pinkfish/hotswap_toolhead/gerber/toolhead-bom-jlcpcb.csv

Comment | Designator | Footprint | LCSC Part #
0R | R7,R8 | R_0402_1005Metric | C17168
100R | R6 | R_0402_1005Metric | C25076
100nF | C6,C9,C12,C15,C16,C19,C20 | C_0402_1005Metric | C1525
100nF | C5 | C_0603_1608Metric | C14663
10k | R1,R3,R13,R14,R16,R22 | R_0402_1005Metric | C25744
10uF 25V X5R | C10,C17 | C_0805_2012Metric | C15850
10uF 50V X5R | C2,C3,C4 | C_1206_3216Metric | C13585
120R | R11 | R_0805_2012Metric | C17437
1k | R4,R5,R15,R19,R23 | R_0402_1005Metric | C11702
1uF | C11 | C_0402_1005Metric | C52923
22uF 25V X5R | C8 | C_1206_3216Metric | C12891
22uH 1.2A (FNR4030S220MT) | L1 | L_Taiyo-Yuden_NR-40xx | C167883
33k | R2 | R_0402_1005Metric | C25779
33pF C0G | C13,C14 | C_0402_1005Metric | C1562
4.12k 0.1% 25ppm | R18 | R_0402_1005Metric | C852812
4.7k 0.1% 25ppm | R17 | R_0402_1005Metric | C281778
47uF 50V 105C | C1 | CP_Elec_6.3x7.7 | C72523
5.1k | R20,R21 | R_0402_1005Metric | C25905
600R@100MHz | FB1 | L_0402_1005Metric | C76884
6A 1206 fuse (BSMD1206C-1600T) | F1 | Fuse_1206_3216Metric | C49328461
8MHz 20pF 3225 | Y1 | Crystal_SMD_3225-4Pin_3.2x2.5mm | C9002
BAT54S | D6 | SOT-23 | C7420333
BOOT | SW2 | SW_SPST_EVQP7C | C528965
DSK110 100V 1A | D3,D5,D7,D9 | D_SOD-123F | C22466354
Fan/therm/sensor (Nano-Fit 2x3) | J3 | Molex_Nano-Fit_105314-xx06_2x03_P2.50mm_Horizontal | C586245
Heater (Nano-Fit 2) | J2 | Molex_Nano-Fit_105313-xx02_1x02_P2.50mm_Horizontal | C564339
LMR16006XDDC | U1 | SOT-23-6 | C87080
MMSZ5242B 12V | D2 | D_SOD-123 | C19077426
N-FET 60V <=30mR@2.5V | Q2 | Vishay_PowerPAK_1212-8_Single
NTC/PT1000 | JP2 | PinHeader_1x02_P2.00mm_Vertical | C541856
NUP2105L | D4 | SOT-23 | C14486
PTC 0.75A 33V (JK-mSMD075-33) | F2 | Fuse_1812_4532Metric | C369169
RESET | SW1 | SW_SPST_EVQP7C | C528965
SMAJ33CA | D1 | D_SMA | C19077549
SQJ461EP-T1_GE3 | Q1 | PowerPAK_SO-8_Single | C3279500
STM32G0B1CBU6 | U6 | QFN-48-1EP_7x7mm_P0.5mm_EP5.6x5.6mm | C5270156
TCAN3414DR | U3 | SOIC-8_3.9x4.9mm_P1.27mm | C22396693
TERM | JP1 | SolderJumper-2_P1.3mm_Open_RoundedPad1.0x1.5mm
USB-C (HRO TYPE-C-31-M-12) | J5 | USB_C_Receptacle_HRO_TYPE-C-31-M-12 | C165948
USBLC6-2SC6 | U5 | SOT-23-6 | C7519
WST6066A | Q3 | SOT-23 | C148352
XT30PW(2+2)-M.G.B | J1 | XT30PW-2+2-M | C19268030
blue | LED2 | LED_0603_1608Metric | C2288
yellow-green | LED1 | LED_0603_1608Metric | C2289
