pinkfish/hotswap_toolhead/hardware/production/bom.csv

Designator | Footprint | Quantity | Value | LCSC Part #
C1 | CP_Elec_6.3x7.7 | 1 | 47uF 50V 105C
C10, C17 | 0805 | 2 | 10uF 25V X5R | C15850
C11 | 0603 | 1 | 1uF | C15849
C12, C15, C16, C19, C5, C6, C9 | 0603 | 7 | 100nF | C14663
C13, C14 | 0603 | 2 | 33pF C0G | C1663
C18 | 0603 | 1 | 100nF 50V | C14663
C2, C3, C4 | 1206 | 3 | 10uF 50V X5R | C13585
C8 | 1206 | 1 | 22uF 25V X5R | C12891
D1 | D_SMB | 1 | SMBJ33CA
D2 | D_SOD-123 | 1 | 12V zener
D3, D5, D7, D9 | D_SMA | 4 | SS210 | C14996
D4 | SOT-23 | 1 | NUP2105L
D6 | SOT-23 | 1 | BAT54S
F1 | 1206 | 1 | 6.3A fast
F2 | 1812 | 1 | PTC 0.75A hold 30V
FB1 | 0603 | 1 | 600R@100MHz | C1002
J1 | XT30PW-2+2-M | 1 | XT30PW(2+2)-M.G.B | C19268030
J2 | Molex_Nano-Fit_105313-xx02_1x02_P2.50mm_Horizontal | 1 | Heater (Nano-Fit 2)
J3 | JST_SH_SM02B-SRSS-TB_1x02-1MP_P1.00mm_Horizontal | 1 | Fan (JST-SH 2 side)
J4 | JST_SH_BM02B-SRSS-TB_1x02-1MP_P1.00mm_Vertical | 1 | Thermistor (JST-SH 2 top)
J5 | JST_SH_SM04B-SRSS-TB_1x04-1MP_P1.00mm_Horizontal | 1 | USB (JST-SH 4)
J6 | Tag-Connect_TC2030-IDC-NL_2x03_P1.27mm_Vertical | 1 | TC2030 SWD
JP1 | SolderJumper-2_P1.3mm_Open_RoundedPad1.0x1.5mm | 1 | TERM
JP2 | PinHeader_1x02_P2.54mm_Vertical | 1 | NTC/PT1000
L1 | L_Taiyo-Yuden_NR-40xx | 1 | 22uH (per datasheet)
LED1 | 0603 | 1 | green
LED2 | 0603 | 1 | blue
Q1 | PowerPAK_SO-8_Single | 1 | P-FET 60V >=8A
Q2, Q3 | Vishay_PowerPAK_1212-8_Single | 2 | N-FET 60V <=30mR@2.5V
R1, R13, R14, R16, R3 | 0603 | 5 | 10k
R10, R12, R7, R8, R9 | 0603 | 5 | 0R | C21189
R11 | 0805 | 1 | 120R | C17437
R15, R19, R4, R5, R6 | 0603 | 5 | 1k
R17 | 0603 | 1 | 4.7k 0.1% 25ppm
R18 | 0603 | 1 | 4.12k 0.1% 25ppm
R2 | 0603 | 1 | FB top (datasheet)
SW1 | SW_SPST_TL3342 | 1 | RESET
SW2 | SW_SPST_TL3342 | 1 | BOOT
U1 | SOT-23-6 | 1 | LMR16006XDDC
U3 | SOIC-8_3.9x4.9mm_P1.27mm | 1 | MAX33012E (check pin 5)
U5 | SOT-23-6 | 1 | USBLC6-2SC6
U6 | LQFP-48_7x7mm_P0.5mm | 1 | STM32G0B1CBT7
Y1 | Crystal_SMD_5032-2Pin_5.0x3.2mm | 1 | 8MHz 20pF | C115962
