pinkfish/hotswap_toolhead/hardware/toolhead.kicad_pcb

## KiCad design hardware/toolhead.kicad_pcb (2026-10-26)

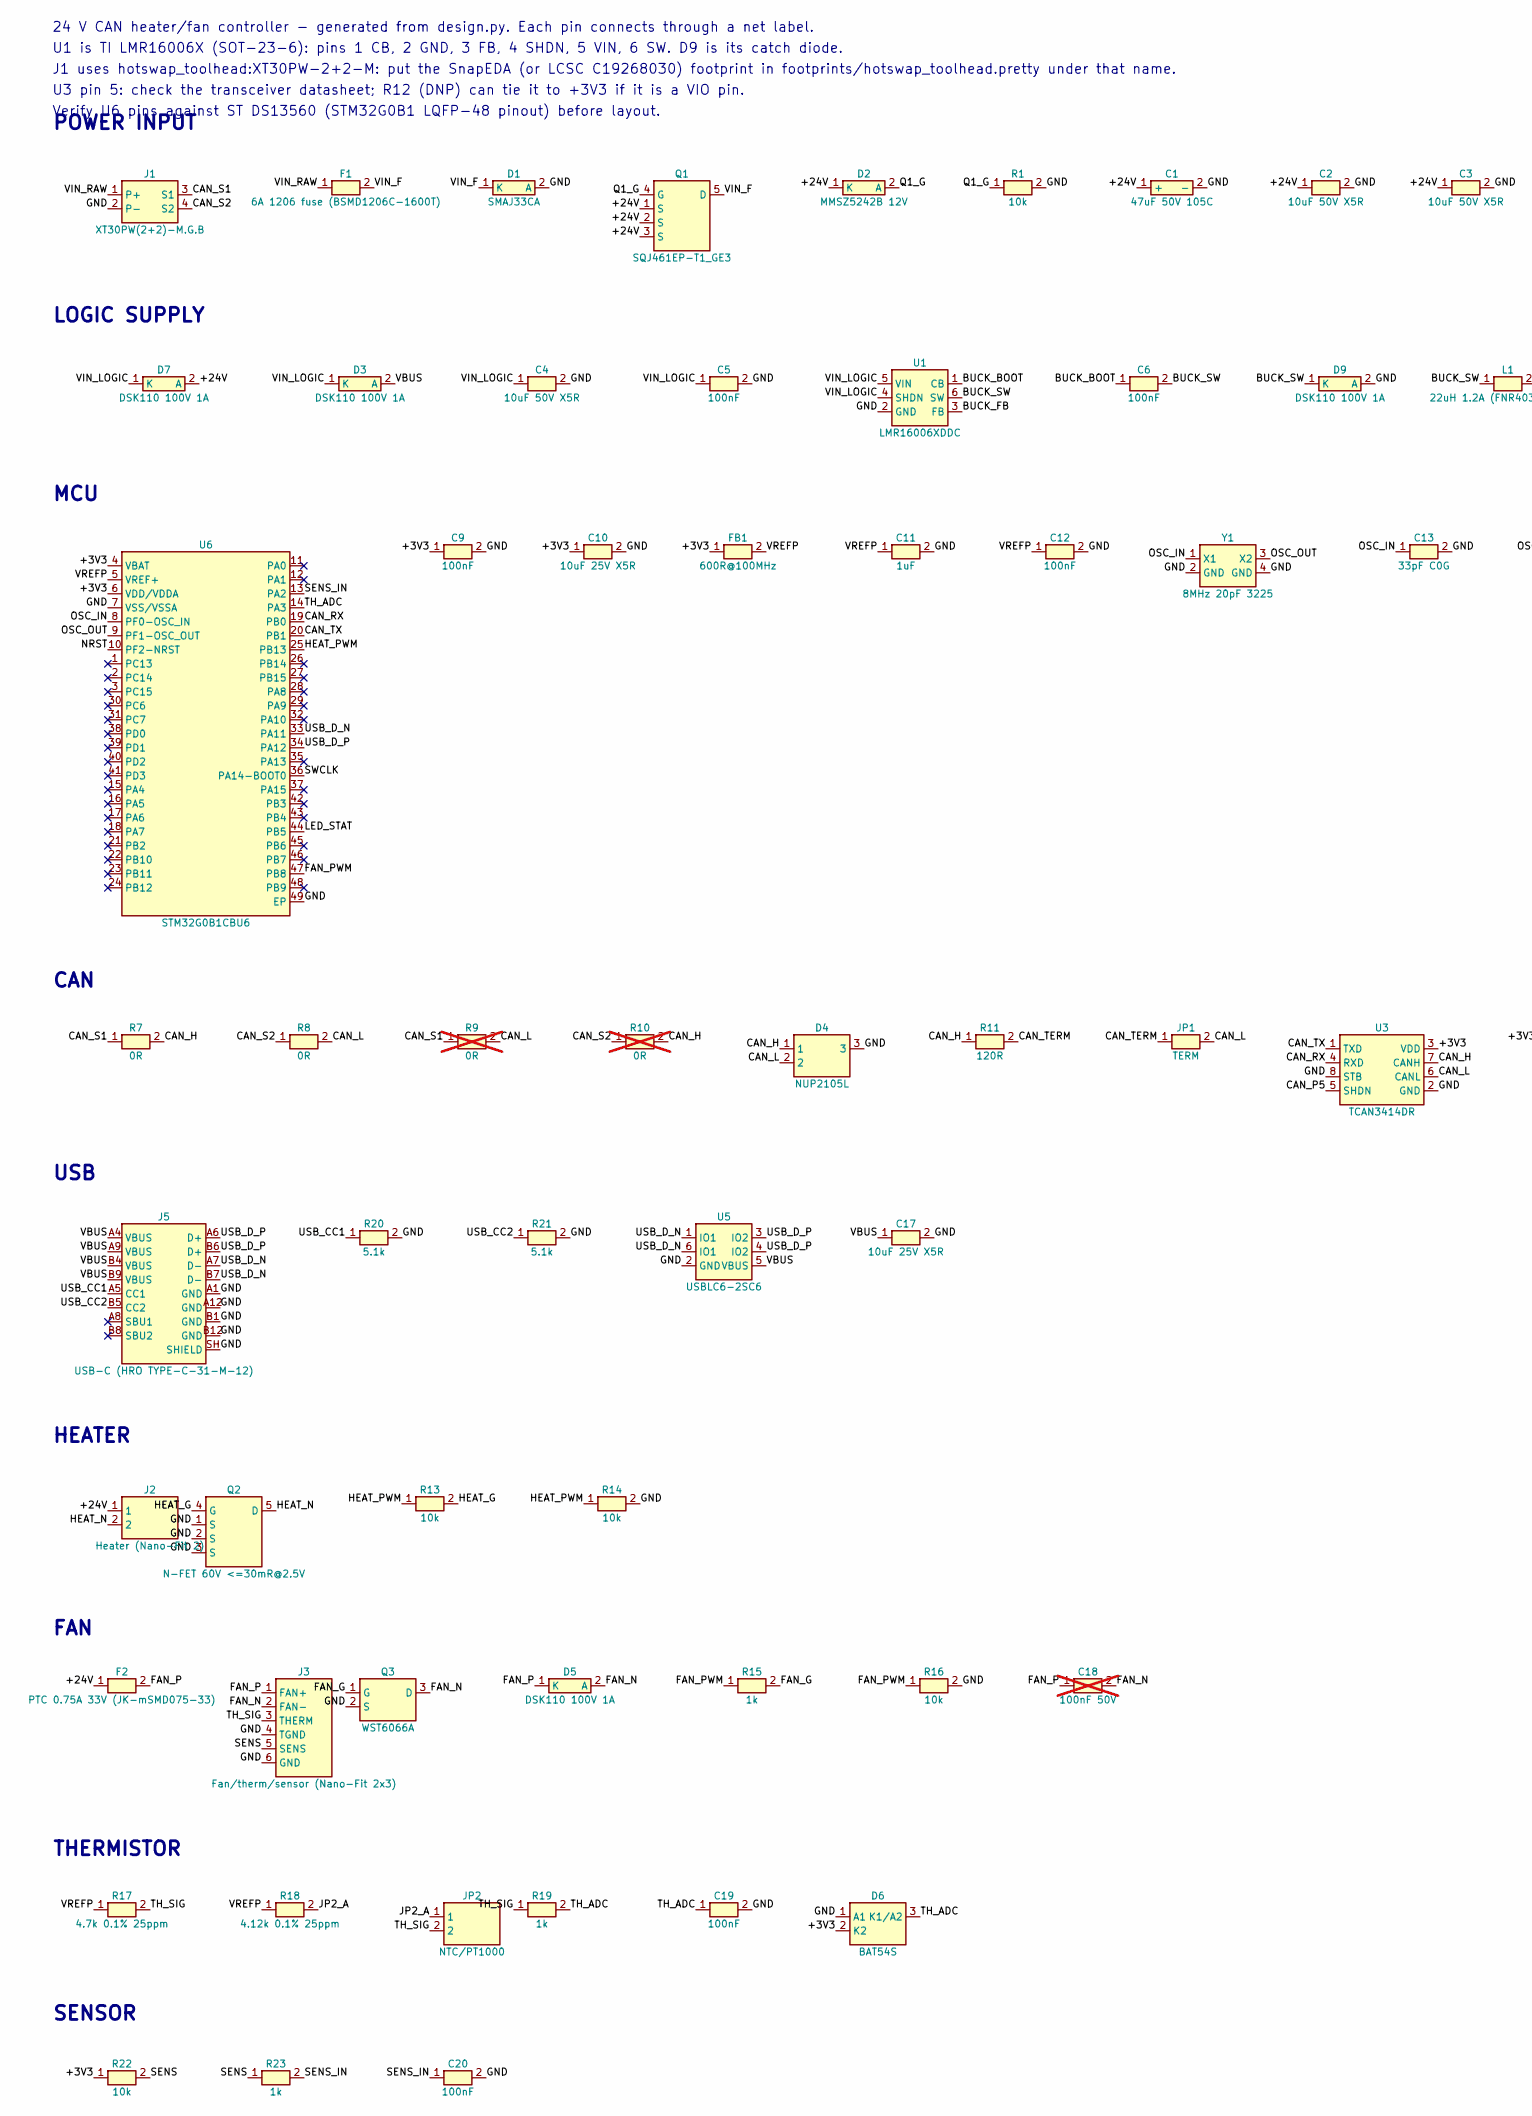
[picture p2: schematic toolhead.kicad_sch, 24V CAN heater/fan controller, part in row 1, column 1]

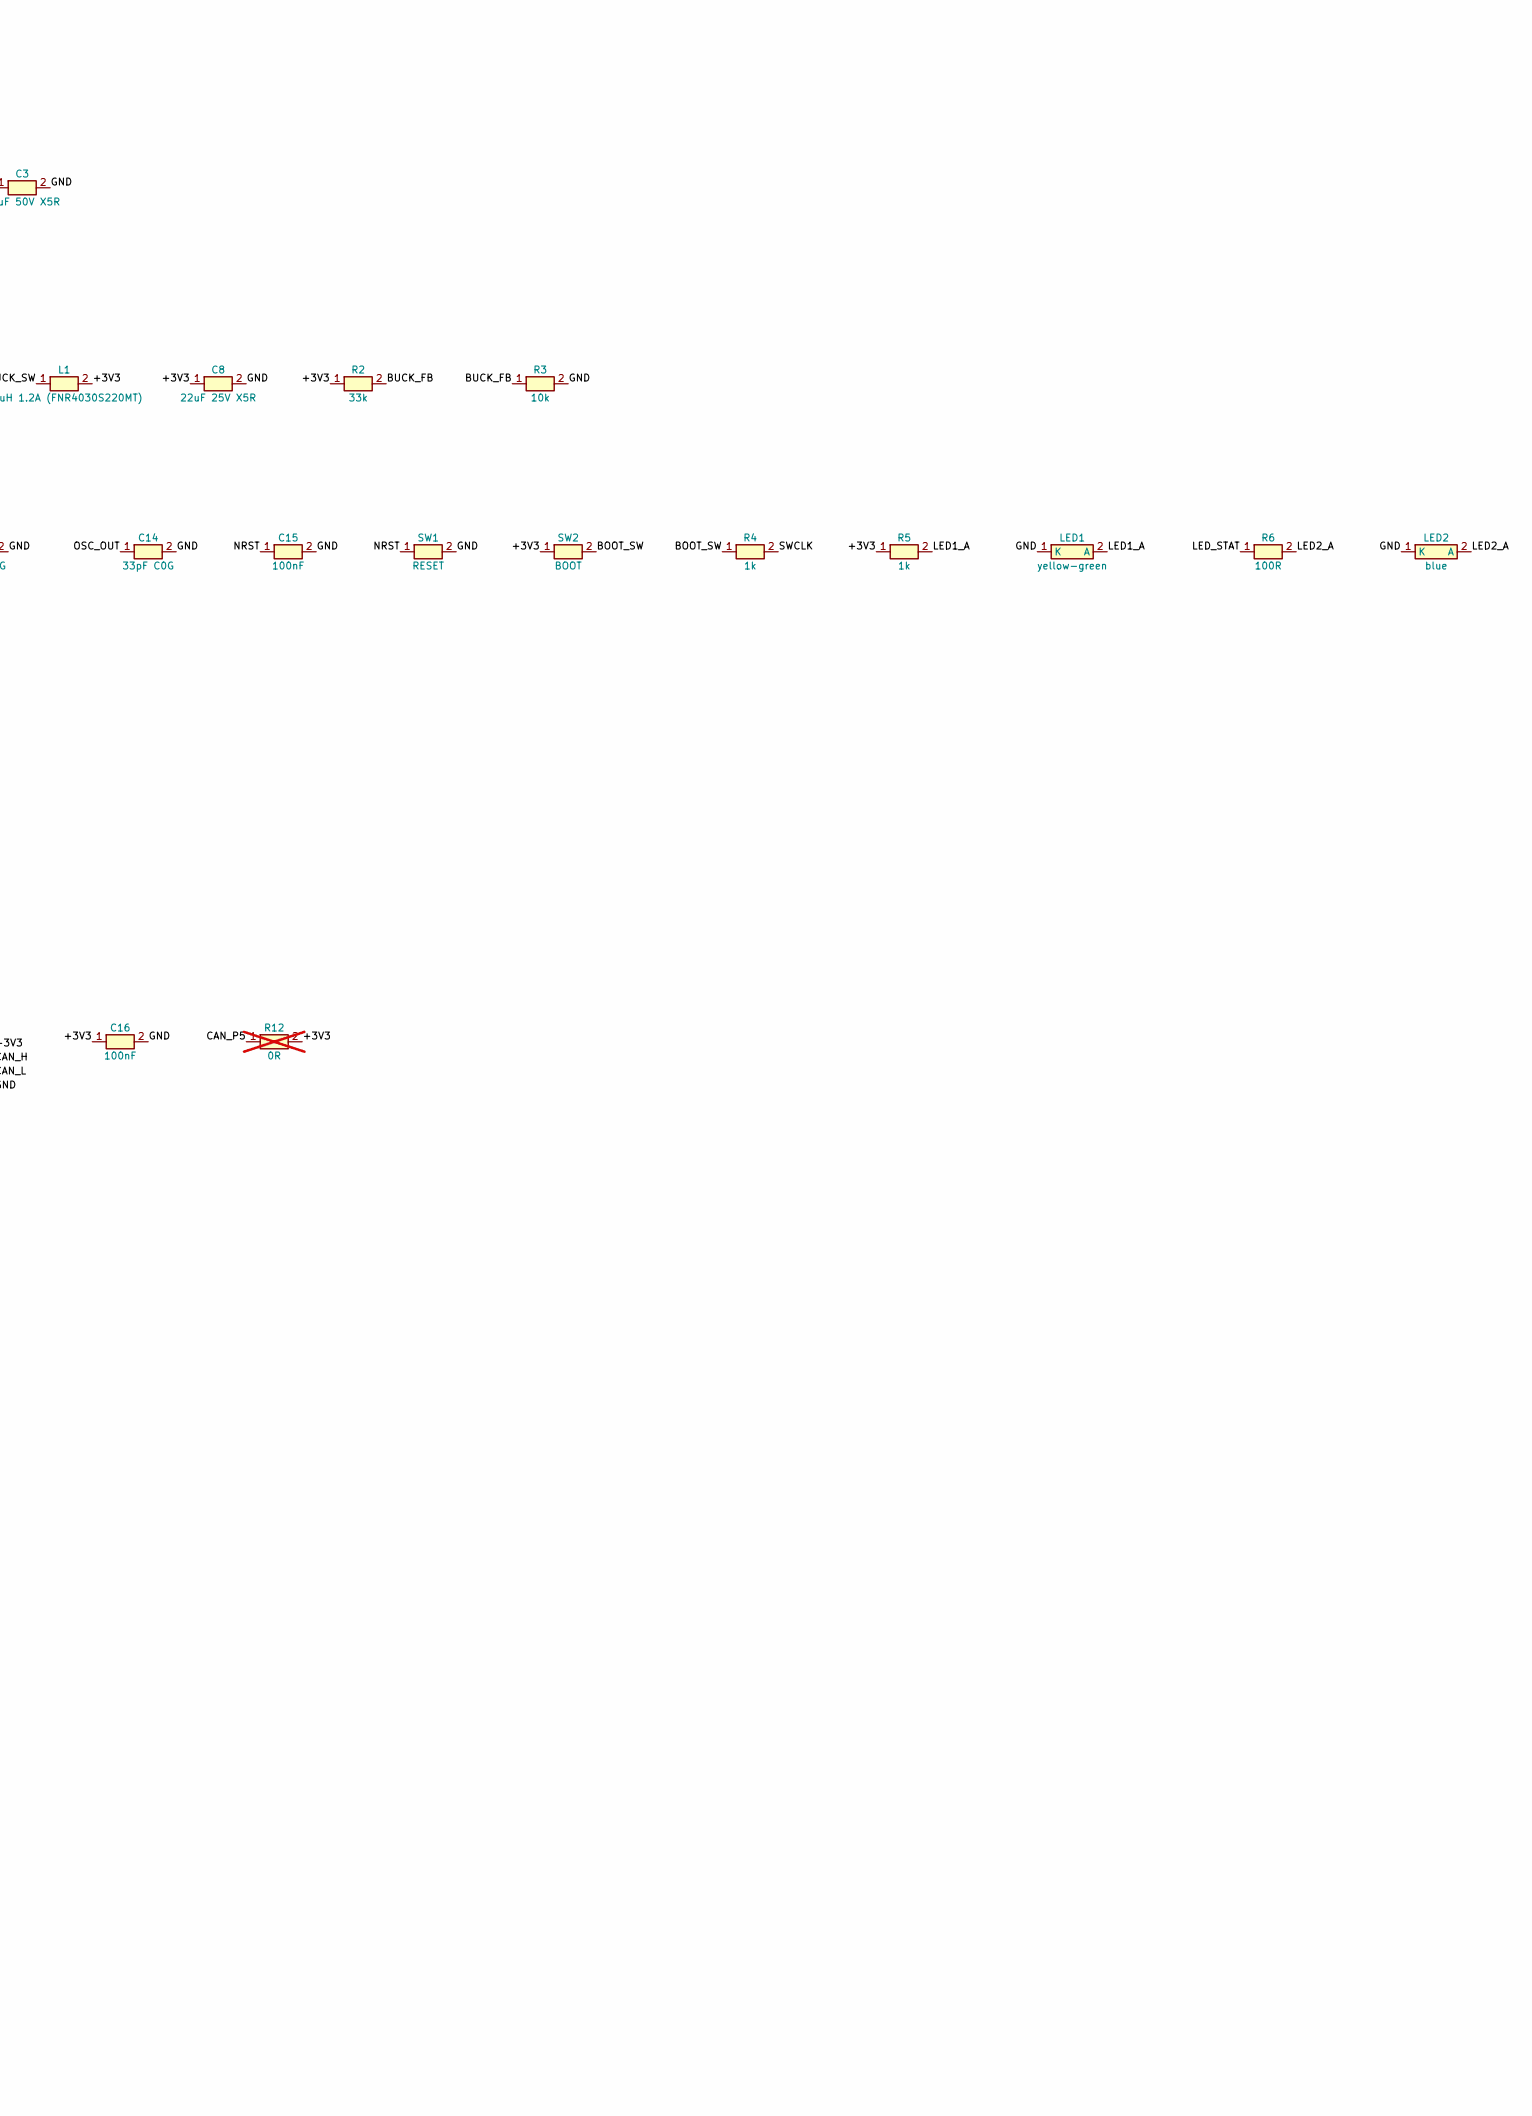
[picture p3: schematic toolhead.kicad_sch, 24V CAN heater/fan controller, part in row 1, column 2]

Parts:
C1: 47uF 50V 105C; CP_Elec_6.3x7.7; LCSC C72523
C2, C3, C4: 10uF 50V X5R; C_1206_3216Metric; LCSC C13585
C5: 100nF; C_0603_1608Metric; LCSC C14663
C6, C9, C12, C15, C16, C19, C20: 100nF; C_0402_1005Metric; LCSC C1525
C8: 22uF 25V X5R; C_1206_3216Metric; LCSC C12891
C10, C17: 10uF 25V X5R; C_0805_2012Metric; LCSC C15850
C11: 1uF; C_0402_1005Metric; LCSC C52923
C13, C14: 33pF C0G; C_0402_1005Metric; LCSC C1562
C18: 100nF 50V; C_0603_1608Metric; LCSC C14663; not fitted
D1: SMAJ33CA; D_SMA; LCSC C19077549
D2: MMSZ5242B 12V; D_SOD-123; LCSC C19077426
D3, D5, D7, D9: DSK110 100V 1A; D_SOD-123F; LCSC C22466354
D4: NUP2105L; SOT-23; LCSC C14486
D6: BAT54S; SOT-23; LCSC C7420333
F1: 6A 1206 fuse (BSMD1206C-1600T); Fuse_1206_3216Metric; LCSC C49328461
F2: PTC 0.75A 33V (JK-mSMD075-33); Fuse_1812_4532Metric; LCSC C369169
FB1: 600R@100MHz; L_0402_1005Metric; LCSC C76884
J1: XT30PW(2+2)-M.G.B; XT30PW-2+2-M; LCSC C19268030
J2: Heater (Nano-Fit 2); Molex_Nano-Fit_105313-xx02_1x02_P2.50mm_Horizontal; LCSC C564339
J3: Fan/therm/sensor (Nano-Fit 2x3); Molex_Nano-Fit_105314-xx06_2x03_P2.50mm_Horizontal; LCSC C586245
J5: USB-C (HRO TYPE-C-31-M-12); USB_C_Receptacle_HRO_TYPE-C-31-M-12; LCSC C165948
JP1: TERM; SolderJumper-2_P1.3mm_Open_RoundedPad1.0x1.5mm
JP2: NTC/PT1000; PinHeader_1x02_P2.00mm_Vertical; LCSC C541856
L1: 22uH 1.2A (FNR4030S220MT); L_Taiyo-Yuden_NR-40xx; LCSC C167883
LED1: yellow-green; LED_0603_1608Metric; LCSC C2289
LED2: blue; LED_0603_1608Metric; LCSC C2288
Q1: SQJ461EP-T1_GE3; PowerPAK_SO-8_Single; LCSC C3279500
Q2: N-FET 60V <=30mR@2.5V; Vishay_PowerPAK_1212-8_Single
Q3: WST6066A; SOT-23; LCSC C148352
R1, R3, R13, R14, R16, R22: 10k; R_0402_1005Metric; LCSC C25744
R2: 33k; R_0402_1005Metric; LCSC C25779
R4, R5, R15, R19, R23: 1k; R_0402_1005Metric; LCSC C11702
R6: 100R; R_0402_1005Metric; LCSC C25076
R7, R8: 0R; R_0402_1005Metric; LCSC C17168
R9, R10, R12: 0R; R_0402_1005Metric; LCSC C17168; not fitted
R11: 120R; R_0805_2012Metric; LCSC C17437
R17: 4.7k 0.1% 25ppm; R_0402_1005Metric; LCSC C281778
R18: 4.12k 0.1% 25ppm; R_0402_1005Metric; LCSC C852812
R20, R21: 5.1k; R_0402_1005Metric; LCSC C25905
SW1: RESET; SW_SPST_EVQP7C; LCSC C528965
SW2: BOOT; SW_SPST_EVQP7C; LCSC C528965
U1: LMR16006XDDC; SOT-23-6; LCSC C87080
U3: TCAN3414DR; SOIC-8_3.9x4.9mm_P1.27mm; LCSC C22396693
U5: USBLC6-2SC6; SOT-23-6; LCSC C7519
U6: STM32G0B1CBU6; QFN-48-1EP_7x7mm_P0.5mm_EP5.6x5.6mm; LCSC C5270156
Y1: 8MHz 20pF 3225; Crystal_SMD_3225-4Pin_3.2x2.5mm; LCSC C9002

Connections:
/+3V3: C8.1, C9.1, C10.1, C16.1, D6.2 (K2), FB1.1, L1.2, R2.1, R5.1, R12.2, R22.1, SW2.1, U3.3 (VDD), U6.4 (VBAT), U6.6 (VDD/VDDA)
/+24V: C1.1 (+), C2.1, C3.1, D2.1 (K), D7.2 (A), F2.1, J2.1, Q1.1 (S), Q1.2 (S), Q1.3 (S)
/BOOT_SW: R4.1, SW2.2
/BUCK_BOOT: C6.1, U1.1 (CB)
/BUCK_FB: R2.2, R3.1, U1.3 (FB)
/BUCK_SW: C6.2, D9.1 (K), L1.1, U1.6 (SW)
/CAN_H: D4.1, R7.2, R10.2, R11.1, U3.7 (CANH)
/CAN_L: D4.2, JP1.2, R8.2, R9.2, U3.6 (CANL)
/CAN_P5: R12.1, U3.5 (PIN5_CHECK)
/CAN_RX: U3.4 (RXD), U6.19 (PB0)
/CAN_S1: J1.3 (S1), R7.1, R9.1
/CAN_S2: J1.4 (S2), R8.1, R10.1
/CAN_TERM: JP1.1, R11.2
/CAN_TX: U3.1 (TXD), U6.20 (PB1)
/FAN_G: Q3.1 (G), R15.2
/FAN_N: C18.2, D5.2 (A), J3.2 (FAN-), Q3.3 (D)
/FAN_P: C18.1, D5.1 (K), F2.2, J3.1 (FAN+)
/FAN_PWM: R15.1, R16.1, U6.47 (PB8)
/GND: C1.2 (-), C2.2, C3.2, C4.2, C5.2, C8.2, C9.2, C10.2, C11.2, C12.2, C13.2, C14.2, C15.2, C16.2, C17.2, C19.2, C20.2, D1.2 (A), D4.3, D6.1 (A1), D9.2 (A), J1.2 (P-), J3.4 (TGND), J3.6 (GND), J5.A1 (GND), J5.A12 (GND), J5.B1 (GND), J5.B12 (GND), J5.SH (SHIELD), LED1.1 (K), LED2.1 (K), Q2.1 (S), Q2.2 (S), Q2.3 (S), Q3.2 (S), R1.2, R3.2, R14.2, R16.2, R20.2, R21.2, SW1.2, U1.2 (GND), U3.2 (GND), U3.8 (STBY), U5.2 (GND), U6.7 (VSS/VSSA), U6.49 (EP), Y1.2 (GND), Y1.4 (GND)
/HEAT_G: Q2.4 (G), R13.2
/HEAT_N: J2.2, Q2.5 (D)
/HEAT_PWM: R13.1, R14.1, U6.25 (PB13)
/JP2_A: JP2.1, R18.2
/LED1_A: LED1.2 (A), R5.2
/LED2_A: LED2.2 (A), R6.2
/LED_STAT: R6.1, U6.44 (PB5)
/NRST: C15.1, SW1.1, U6.10 (PF2-NRST)
/OSC_IN: C13.1, U6.8 (PF0-OSC_IN), Y1.1 (X1)
/OSC_OUT: C14.1, U6.9 (PF1-OSC_OUT), Y1.3 (X2)
/Q1_G: D2.2 (A), Q1.4 (G), R1.1
/SENS: J3.5 (SENS), R22.2, R23.1
/SENS_IN: C20.1, R23.2, U6.13 (PA2)
/SWCLK: R4.2, U6.36 (PA14-BOOT0)
/TH_ADC: C19.1, D6.3 (K1/A2), R19.2, U6.14 (PA3)
/TH_SIG: J3.3 (THERM), JP2.2, R17.2, R19.1
/USB_CC1: J5.A5 (CC1), R20.1
/USB_CC2: J5.B5 (CC2), R21.1
/USB_D_N: J5.A7 (D-), J5.B7 (D-), U5.1 (IO1), U5.6 (IO1), U6.33 (PA11)
/USB_D_P: J5.A6 (D+), J5.B6 (D+), U5.3 (IO2), U5.4 (IO2), U6.34 (PA12)
/VBUS: C17.1, D3.2 (A), J5.A4 (VBUS), J5.A9 (VBUS), J5.B4 (VBUS), J5.B9 (VBUS), U5.5 (VBUS)
/VIN_F: D1.1 (K), F1.2, Q1.5 (D)
/VIN_LOGIC: C4.1, C5.1, D3.1 (K), D7.1 (K), U1.4 (SHDN), U1.5 (VIN)
/VIN_RAW: F1.1, J1.1 (P+)
/VREFP: C11.1, C12.1, FB1.2, R17.1, R18.1, U6.5 (VREF+)

Notes on the sheet:
POWER INPUT
LOGIC SUPPLY
MCU
CAN
USB
HEATER
FAN
THERMISTOR
SENSOR
24 V CAN heater/fan controller - generated from design.py. Each pin connects through a net label.
U1 is TI LMR16006X (SOT-23-6): pins 1 CB, 2 GND, 3 FB, 4 SHDN, 5 VIN, 6 SW. D9 is its catch diode.
J1 uses hotswap_toolhead:XT30PW-2+2-M: put the SnapEDA (or LCSC C19268030) footprint in footprints/hotswap_toolhead.pretty under that name.
U3 pin 5: check the transceiver datasheet; R12 (DNP) can tie it to +3V3 if it is a VIO pin.
Verify U6 pins against ST DS13560 (STM32G0B1 LQFP-48 pinout) before layout.

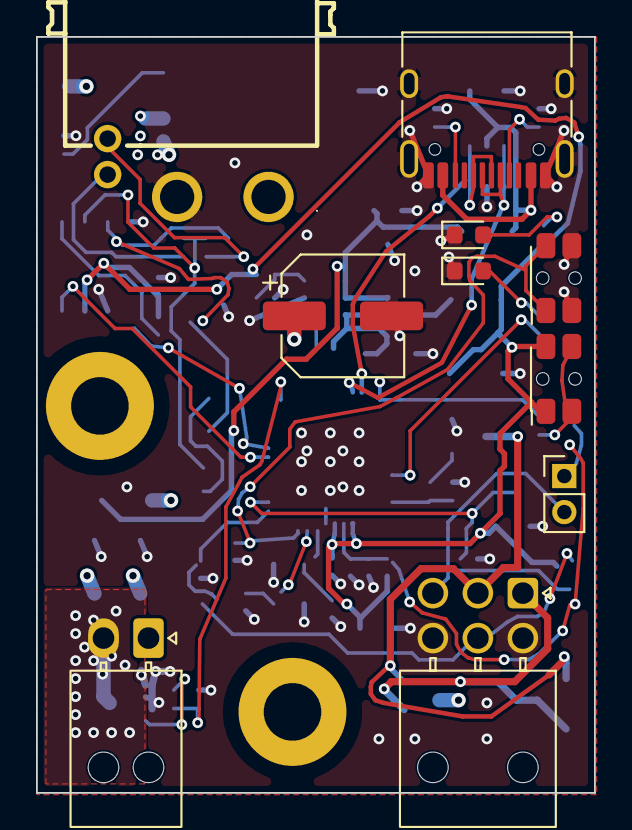
[picture p4: board toolhead.kicad_pcb from above]

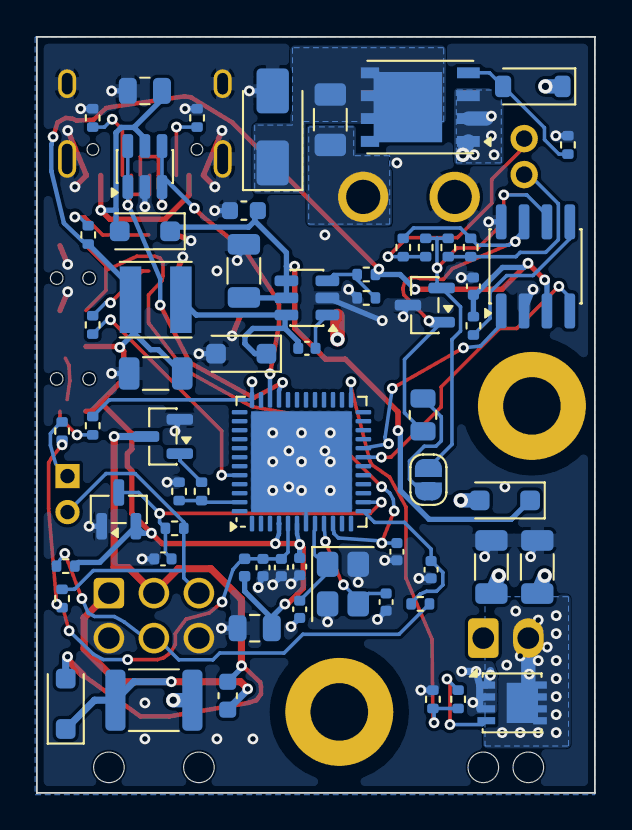
[picture p5: board toolhead.kicad_pcb from below]

Board: 4 copper layers, 31.0 x 42.0 mm, 74 parts (62 on the bottom side), 44 nets.

Other parts of the board:
H1, H2: M3 isolated; MountingHole_3.2mm_M3_Pad
