pinkfish/hotswap_toolhead/(commit log)

2026-10-24 Initial commit: 24 V CAN toolhead board design, KiCad project and generator
    [bom_jlcpcb.csv, toolhead.kicad_pcb, toolhead.kicad_sch]
2026-10-24 Update design: FET footprints, LMR16006 buck, XT30(2+2) library, docs
    [bom_jlcpcb.csv, toolhead.kicad_pcb, toolhead.kicad_sch]
2026-10-24 Update setup and create gerber files
    [toolhead-B_Cu.gbl, toolhead-B_Cu.gbr, toolhead-B_Mask.gbr, toolhead-B_Mask.gbs, toolhead-B_Paste.gbp, toolhead-B_Paste.gbr, toolhead-B_Silkscreen.gbo, toolhead-B_Silkscreen.gbr]
2026-10-25 Update the parts
    Add a usb-c connector
    Move to a single 6 pin header
    [bom.csv, bom_jlcpcb.csv, designators.csv, positions.csv, toolhead-bom-jlcpcb.csv, toolhead.kicad_pcb, toolhead.kicad_sch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]
2026-10-25 next try and making it, making the board narrower, still too big though
    [bom_jlcpcb.csv, toolhead.kicad_sch]
2026-10-26 Next version of shrinking the package
    [bom_jlcpcb.csv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]
